philipf/dough-ray-me/(commit log)

2026-07-10 Add Arduino PoCs: blink, LCD, DS18B20, relay, temp display, thermostat
    Hardware-verified proof-of-concept sketches for an Arduino Uno + DFRobot
    1602 LCD Keypad Shield, each with a pinned sketch.yaml (arduino-cli) profile:
    - blink / lcd-shield / ds18b20 / relay: single-peripheral baselines
    - temp-disp: DS18B20 temperature on the LCD and serial, non-overlapping pins
    - thermostat: closed-loop heater control (DS18B20 + relay + LCD) with
    hysteresis around a 22 C setpoint (ON <21.5, OFF >22.5), sensor-fail-safe
    Pin map is deconflicted across all peripherals: D2 sensor, D3 relay,
    D4-D10 shield, A0 buttons (reserved), A1-A5/D11-D12 free.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
    [ds18b20.ino, lcd-shield.ino, relay.ino, temp-disp.ino, thermostat.ino]
2026-07-11 Add spec, domain glossary, and ADRs for dough-ray-me
    Capture the design settled during the grilling session: SPEC.md (problem,
    user stories, implementation/testing decisions, scope), CONTEXT.md glossary,
    and ADRs for fail-safe heating + over-temp cutoff, the non-blocking loop, and
    the temperature-control-only scope boundary.
2026-07-11 Add non-blocking control spine holding a fixed Setpoint (#1)
    Graduate the thermostat PoC into firmware/dough-ray-me: a non-blocking loop
    (ADR-0002) reads the DS18B20 asynchronously and drives the relay/LED, LCD, and
    serial from a pure, host-tested hysteresis control decision (control.h) at a
    fixed compile-time Setpoint 24 C / Tolerance +/-0.5 C.
    Host tests cover heat ON below the band, OFF above it, hold inside, and the
    exact band edges. Compiles for arduino:avr:uno (24% flash, 18% RAM).
    [control.h, dough-ray-me.ino]
2026-07-11 Apply #1 code-review fixes
    - Fix 16x2 overflow: line 2 was 17 chars ("Heat:ON Set:24.0"), clipping the
    Setpoint; abbreviate to "S:" so it fits and pad to wipe stale chars.
    - Trim the sensor-fault branch to bare safe glue (heater off); defer the fault
    Alarm/UI and 35 C cutoff to ticket #2 (ADR-0001) instead of leaking its scope.
    - Remove the dead haveReading flag (speculative generality; never read).
    [dough-ray-me.ino]
2026-07-11 Add keypad screens and live Setpoint/Tolerance editing (#3)
    [dough-ray-me.ino, ui.h]
2026-07-11 Add safety gate: sensor fail-safe, 35 °C Safety Cutoff, and Alarm (#2)
    [dough-ray-me.ino, safety.h]
2026-07-11 Apply code-review fixes: Home Tolerance, alarm-string unification
    - Home screen now shows all four spec'd read-only fields: Box Air
    Temperature + heat state on row 0, Setpoint + Tolerance on row 1
    (closes the #3 acceptance-criteria gap).
    - Single alarmLabel() helper is the one source of truth for Alarm
    wording, shared by the LCD Alarm screen and the serial line.
    - Rename shownToleranceDeci -> shownToleranceCenti (it holds centi-degrees).
    - Add CODING_STANDARDS.md codifying the repo's pure-unit + host-test,
    non-blocking, fail-safe, and ubiquitous-language conventions.
    [dough-ray-me.ino]
2026-07-11 Persist Setpoint and Tolerance to EEPROM (#4)
    The baker's chosen Setpoint and Tolerance now survive a power cut, so a
    bump or blip mid-bake no longer silently reverts the ferment to defaults.
    - persist.h -- new pure, host-tested unit (the agreed seam): persistStep()
    debounces writes (a change to either value (re)starts a ~2 s timer; only
    once the values hold steady does it ask for one write, so holding Up/Down
    to ramp costs a single write, not one per step -- sparing EEPROM wear);
    persistDecode() validates the boot read-back against a magic marker and
    the documented ranges, falling back to the 24 C / +/-0.5 C defaults on a
    fresh chip or garbage (NaN included). Time is threaded i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
    [dough-ray-me.ino, persist.h]
2026-07-11 Add Stats screen: min/max Box Air Temperature and Heater Duty (#5)
    Fill in the read-only Stats screen (its shell arrived in #3) so the baker
    can characterise the box over a bake.
    New pure unit stats.h holds the since-power-on accumulators, threaded in
    and out with value semantics like the other units:
    * min/max Box Air Temperature -- only valid readings observed, the first
    seeds both ends.
    * Heater Duty -- ON-time accrued from elapsed millis() against the actual
    relay state, so time the safety gate forces the heater OFF counts as
    OFF. The percent multiply is widened to 64-bit so a multi-hour bake
    can't overflow the Uno's 32-bit millis math.
    The .ino accrues duty every l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
2026-07-11 Reject off-grid EEPROM values on boot
    persistDecode() previously trusted any in-range read-back, but uiStep() can
    only ever produce values on the 0.5 / 0.25 grid. An in-range but off-grid
    value (stale bytes from a prior firmware with different steps, or a corrupt
    float that lands in range) would drive the control law off-grid and never
    self-correct, since uiStep only adds/subtracts a step.
    Add persistOnGrid() and require both Setpoint and Tolerance to sit on their
    grids alongside the existing range check; anything off-grid falls back to the
    documented defaults with the rest of an invalid block. Covered by new host
    tests in test_persist.cpp (54 checks, 0 failures).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
    [persist.h]
2026-07-11 Add boot splash and complete the serial line (#6)
    Boot splash: paint "dough-ray-me" for ~1.5 s on power-on, then hand
    straight to Home (updateDisplay() repaints Home right after the splash,
    so there is no blank gap before the first sample lands). The delay() is a
    one-time boot step, not the running path ADR-0002 protects -- the control
    loop has not started, the heater is already OFF, and nothing is being
    sampled or edited yet.
    Serial line: add Heater Duty to the once-per-sample log, so it now
    carries Box Air Temperature / Setpoint / Tolerance / heat state /
    Heater Duty (/ Alarm), the full picture the earlier tickets only made
    available piece by piece. USB cable only, nothing else leaves the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
    [dough-ray-me.ino]
2026-07-11 Fix keypad decode: recalibrate ADC bands, debounce, click-only buttons
    The analog keypad ladder was misdecoding on this shield: Down bounces to
    ~406 ADC, which fell in the old Left band (<380 Down / <555 Left), so Down
    paged the menu instead of editing the Setpoint and Left/Right felt unreliable.
    The UI state machine (ui.h) was correct throughout -- this was purely the A0
    decode.
    - Recalibrate KEY_ADC_* thresholds to this unit's measured button centres
    (Right ~12, Up ~143, Down ~329, Left ~529, Select ~750), with the Down/Left
    boundary raised to 455 so Down's contact bounce stays in the Down band.
    - Debounce the ladder: a reading must hold BUTTON_CONFIRM_SCANS (~15 ms) before
    it count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
    [dough-ray-me.ino, ui.h]
2026-07-11 Add README and MIT license
    Plain-English README with an overview, features, hardware, and a
    pointer to SPEC.md. MIT license for the project's own code; third-party
    Arduino libraries (LiquidCrystal, OneWire, DallasTemperature) are pulled
    from the Library Manager, not vendored, so their licenses are unaffected.
2026-07-11 Move host tests out to firmware/test, beside the sketch
    The tests aren't part of the Arduino sketch, so nest them beside it rather
    than inside. Sketch folder stays firmware/dough-ray-me/ (arduino-cli
    requires the .ino name to match its folder). Test includes now reach into
    ../dough-ray-me/ for the headers.
2026-07-11 README: bill of materials with product names, buy links, images
    Name the actual parts (LCD Keypad Shield DFR0009, DS18B20 probe, G3MB-202P
    SSR) with buy links and thumbnails. Images are stored in docs/images/ so
    they survive listing/CDN churn; the buy links are a hint, not a guarantee.
2026-07-11 Move BOM images to repo-root docs/images
    They were committed under firmware/test/docs/images by mistake; the README
    links are relative to the repo root, so put them where the links expect.
2026-07-11 README: add Arduino Uno product link and image to BOM
2026-07-11 history.h: pure Graph-screen history model + host tests (#11)
    Add the pure unit behind the Graph screen: the last 80 minutes of the
    Fermenting Box as 16 windows of 5 minutes, value-semantics threaded like
    stats.h with no Arduino / LCD / OneWire / millis() dependency.
    - historyObserveTemp folds a valid Box Air Temperature reading into the
    current window's running mean; faulted readings are simply not folded.
    - historyAccrue folds elapsed ms + the actual heater relay state into the
    window's Heater Duty and rolls the window over at exactly 5 minutes,
    splitting an interval that crosses the boundary so elapsed time
    accumulates across rollovers (ADR-0002: time threaded in, no clock here).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
2026-07-11 Graph screen: fifth screen live on the LCD (#10)
    Wire the committed history.h model into the UI and the LCD, completing the
    Graph screen: the last 80 minutes of the Fermenting Box as 16 windows of
    5 minutes, top row per-window Heater Duty digits, bottom row Setpoint-
    centered Box Air Temperature deviation bars.
    - ui.h: add UI_GRAPH to the paging cycle after Stats
    (Home -> Setpoint -> Tolerance -> Stats -> Graph -> wrap Home). Select
    still returns Home and Up/Down stay inert on the read-only screen, both
    out of the existing state machine -- only the wrap arithmetic changes.
    Host tests extended for the new wrap order and Graph's inertness.
    - .ino: 8 CGRAM glyphs for the +/-4 deviation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
    [dough-ray-me.ino, ui.h]
2026-07-11 Fix Graph-screen SRAM overflow: keep history copies out of line (#12)
    The Graph screen (#10/#12) reset-looped on the Uno: stuck on the boot
    splash, "flashing" once per reset, silent serial log. Not a logic or
    CGRAM bug -- an SRAM stack overflow.
    The sketch inlines wholly into one main(), and gcc gives each inlined
    by-value temporary its own stack slot. HistoryState is 228 bytes at 16
    columns, so historyAccrue/historyObserveTemp/historyRender copies summed
    into main()'s frame (~1.2 KB). With ~0.9 KB of globals that overflows the
    ATmega328P's 2 KB SRAM, so the stack corrupted the globals at boot and the
    board reset before printing its first serial line.
    Bisected on hardware (before-#10 strea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
    [history.h]
2026-07-11 Graph screen: latch a Safety Cutoff (!) scar on the history (#13)
    The full-screen Alarm only shows while a Safety Cutoff is active (ADR-0001);
    once the box cools past 33 C and re-arms, nothing records that the 35 C
    excursion ever happened. Give the Graph history a permanent scar: any 5-minute
    window in which the Safety Cutoff fired flags a `!` in the top row, replacing
    that column's Heater Duty digit, and it survives the box re-arming.
    - history.h: HistoryWindow gains a latching cutoffFired flag; historyAccrue
    takes the over-temp verdict and latches it on every window the interval
    touches (defaulted false so existing call sites are unchanged). historyRender
    returns a new HISTORY_CUTOF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
2026-07-11 CONTEXT.md: Graph screen term + Heater Duty shown two ways
    Record the Graph screen in the ubiquitous language now that it is live: add a
    "Graph screen" entry (last ~80 minutes, per-window Heater Duty above and Box Air
    Temperature deviation below, since-power-on and RESET-cleared like Stats), and
    broaden "Heater Duty" to note it is shown two ways -- a single since-power-on
    figure on Stats and sliced per time window on the Graph.
2026-07-11 SPEC: clarify 18-30C Setpoint range is not the box's temperature ceiling
    The Setpoint range and the hard 35C Safety Cutoff were documented far
    apart, so 18-30C reads as the box's temperature ceiling. Note at the
    Setpoint decision that box air can drift above the Setpoint with no
    Alarm until the 35C cutoff -- the only over-temperature limit enforced.
